Deadline039/nas-panel/Docs/schematic.pdf

HDD Status | MCU

# Front USB3.0

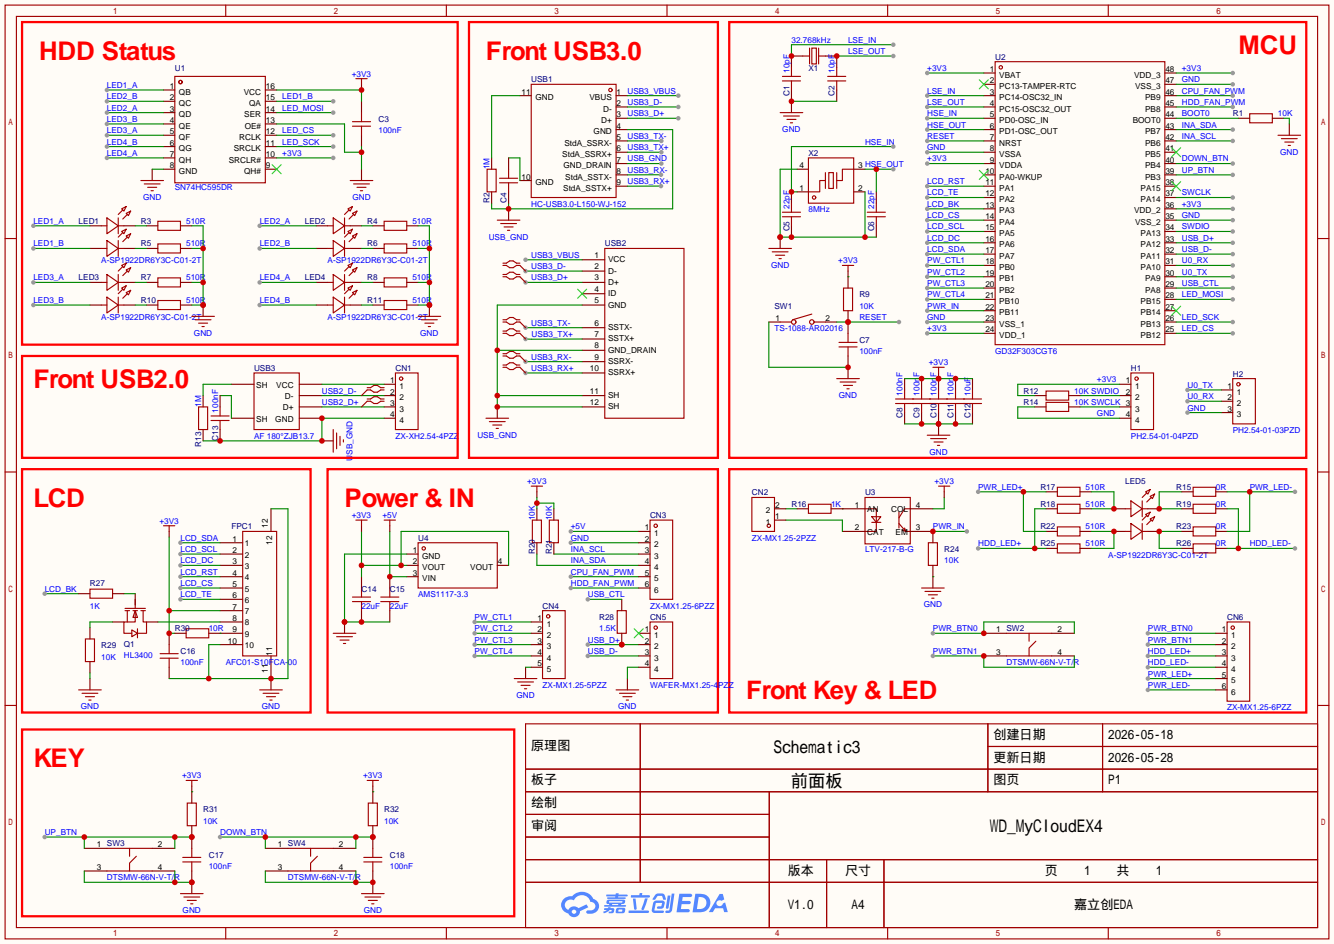
[picture p1: page 1]

SRCLR# 10 SRCLK 11 RCLK 12 OE# 13 SER 14 QA 15 VCC 16

原理图 | Schematic3 | 创建日期 | 2026-05-18

更新日期 | 2026-05-28

板子 | 前面板 | 图页 | P1
绘制 | | WD_MyCloudEX4
审阅

V1.0 | A4 | 嘉立创EDA
