Deadline039/nas-panel/gd32-bootloader/Bsp/lcd/lcd_font.h

/**
 * Copyright (c) 2026, Deadline039
 *
 * SPDX-License-Identifier: MIT
 */

/* INTERNAL USE ONLY, DO NOT INCLUDE THIS FILE */

const unsigned char asc2_1206[95][12] = {
    { 0x00, 0x00, 0x00, 0x00, 0x00, 0x00, 0x00, 0x00, 0x00, 0x00, 0x00, 0x00 }, /*" ",0*/
    { 0x00, 0x00, 0x00, 0x00, 0x3F, 0x40, 0x00, 0x00, 0x00, 0x00, 0x00, 0x00 }, /*"!",1*/
    { 0x00, 0x00, 0x30, 0x00, 0x40, 0x00, 0x30, 0x00, 0x40, 0x00, 0x00, 0x00 }, /*""",2*/
    { 0x09, 0x00, 0x0B, 0xC0, 0x3D, 0x00, 0x0B, 0xC0, 0x3D, 0x00, 0x09, 0x00 }, /*"#",3*/
    { 0x18, 0xC0, 0x24, 0x40, 0x7F, 0xE0, 0x22, 0x40, 0x31, 0x80, 0x00, 0x00 }, /*"$",4*/
    { 0x18, 0x00, 0x24, 0xC0, 0x1B, 0x00, 0x0D, 0x80, 0x32, 0x40, 0x01, 0x80 }, /*"%",5*/
    { 0x03, 0x80, 0x1C, 0x40, 0x27, 0x40, 0x1C, 0x80, 0x07, 0x40, 0x00, 0x40 }, /*"&",6*/
    { 0x10, 0x00, 0x60, 0x00, 0x00, 0x00, 0x00, 0x00, 0x00, 0x00, 0x00, 0x00 }, /*"'",7*/
    { 0x00, 0x00, 0x00, 0x00, 0x00, 0x00, 0x1F, 0x80, 0x20, 0x40, 0x40, 0x20 }, /*"(",8*/
    { 0x00, 0x00, 0x40, 0x20, 0x20, 0x40, 0x1F, 0x80, 0x00, 0x00, 0x00, 0x00 }, /*")",9*/
    { 0x09, 0x00, 0x06, 0x00, 0x1F, 0x80, 0x06, 0x00, 0x09, 0x00, 0x00, 0x00 }, /*"*",10*/
    { 0x04, 0x00, 0x04, 0x00, 0x3F, 0x80, 0x04, 0x00, 0x04, 0x00, 0x00, 0x00 }, /*"+",11*/
    { 0x00, 0x10, 0x00, 0x60, 0x00, 0x00, 0x00, 0x00, 0x00, 0x00, 0x00, 0x00 }, /*",",12*/
    { 0x04, 0x00, 0x04, 0x00, 0x04, 0x00, 0x04, 0x00, 0x04, 0x00, 0x00, 0x00 }, /*"-",13*/
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
      0x00, 0x07, 0xF8, 0x00, 0x00, 0x00, 0x00, 0x00, 0x00, 0x00, 0x00, 0x00, 0x00, 0x00, 0x00, 0x00,
      0x00, 0x00, 0x00, 0x00, 0x00, 0x00, 0x00, 0x00, 0x00, 0x00, 0x00, 0x00, 0x00, 0x00, 0x00, 0x00 }, /*")",9*/
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
};
