Deadline039/nas-panel/gd32-app/App/Inc/bootloader.h

/**
 * Copyright (c) 2026, Deadline039
 *
 * SPDX-License-Identifier: MIT
 */

#ifndef BOOTLOADER_H
#define BOOTLOADER_H

#ifdef __cplusplus
extern "C" {
#endif /* __cplusplus */

void bootloader_request_update(void);

#ifdef __cplusplus
}
#endif /* __cplusplus */

#endif /* BOOTLOADER_H */
