Deadline039/nas-panel/gd32-bootloader/App/Inc/inter_flash_if.h

/**
 * Copyright (c) 2026, Deadline039
 *
 * SPDX-License-Identifier: MIT
 */

#ifndef INTER_FLASH_IF_H
#define INTER_FLASH_IF_H

#include "dfu_mem.h"

#ifdef __cplusplus
extern "C" {
#endif /* __cplusplus */

#define INTER_FLASH_IF_STR "@Internal Flash /0x08008000/240*002Kg,127*004Kg"

#ifdef __cplusplus
}
#endif /* __cplusplus */

#endif /* INTER_FLASH_IF_H */
