Deadline039/nas-panel/(commit log)

2026-09-14 feat: add fan pwm get interface
2026-09-14 modify USB interrupt priority
2026-09-16 feat: add fan curves and fix bugs
    [fan_control.c, fan_control.h, key.c, key.h, ui_task.c]
2026-09-18 fix: bootloader bug fix
    [bootloader.c, bootloader.h, lcd.c, main.c]
2026-09-26 feat: add led state tarnsfer
2026-09-26 feat: add HDD led status set
2026-09-26 feat: add standby led state
2026-09-27 feat: add dark and light auto switch
